armleo/armleo_gpio/xschem/gpio/netlists/libs.spice

.subckt sky130_fd_sc_hd__nand2_4 A B VGND VNB VPB VPWR Y
X0 a_27_47# A Y VNB sky130_fd_pr__nfet_01v8 w=650000u l=150000u
X1 a_27_47# A Y VNB sky130_fd_pr__nfet_01v8 w=650000u l=150000u
X2 Y A VPWR VPB sky130_fd_pr__pfet_01v8_hvt w=1e+06u l=150000u
X3 Y A VPWR VPB sky130_fd_pr__pfet_01v8_hvt w=1e+06u l=150000u
X4 VGND B a_27_47# VNB sky130_fd_pr__nfet_01v8 w=650000u l=150000u
X5 VPWR A Y VPB sky130_fd_pr__pfet_01v8_hvt w=1e+06u l=150000u
X6 Y A a_27_47# VNB sky130_fd_pr__nfet_01v8 w=650000u l=150000u
X7 a_27_47# B VGND VNB sky130_fd_pr__nfet_01v8 w=650000u l=150000u
X8 VGND B a_27_47# VNB sky130_fd_pr__nfet_01v8 w=650000u l=150000u
X9 VPWR B Y VPB sky130_fd_pr__pfet_01v8_hvt w=1e+06u l=150000u
X10 a_27_47# B VGND VNB sky130_fd_pr__nfet_01v8 w=650000u l=150000u
X11 VPWR A Y VPB sky130_fd_pr__pfet_01v8_hvt w=1e+06u l=150000u
X12 VPWR B Y VPB sky130_fd_pr__pfet_01v8_hvt w=1e+06u l=150000u
X13 Y B VPWR VPB sky130_fd_pr__pfet_01v8_hvt w=1e+06u l=150000u
X14 Y A a_27_47# VNB sky130_fd_pr__nfet_01v8 w=650000u l=150000u
X15 Y B VPWR VPB sky130_fd_pr__pfet_01v8_hvt w=1e+06u l=150000u
.ends


.subckt sky130_fd_sc_hd__nor2_4 A B VGND VNB VPB VPWR Y
X0 a_27_297# B Y VPB sky130_fd_pr__pfet_01v8_hvt w=1e+06u l=150000u
X1 Y A VGND VNB sky130_fd_pr__nfet_01v8 w=650000u l=150000u
X2 VPWR A a_27_297# VPB sky130_fd_pr__pfet_01v8_hvt w=1e+06u l=150000u
X3 VPWR A a_27_297# VPB sky130_fd_pr__pfet_01v8_hvt w=1e+06u l=150000u
X4 Y B a_27_297# VPB sky130_fd_pr__pfet_01v8_hvt w=1e+06u l=150000u
X5 VGND A Y VNB sky130_fd_pr__nfet_01v8 w=650000u l=150000u
X6 a_27_297# A VPWR VPB sky130_fd_pr__pfet_01v8_hvt w=1e+06u l=150000u
X7 a_27_297# A VPWR VPB sky130_fd_pr__pfet_01v8_hvt w=1e+06u l=150000u
X8 VGND A Y VNB sky130_fd_pr__nfet_01v8 w=650000u l=150000u
X9 Y B VGND VNB sky130_fd_pr__nfet_01v8 w=650000u l=150000u
X10 a_27_297# B Y VPB sky130_fd_pr__pfet_01v8_hvt w=1e+06u l=150000u
X11 Y A VGND VNB sky130_fd_pr__nfet_01v8 w=650000u l=150000u
X12 Y B VGND VNB sky130_fd_pr__nfet_01v8 w=650000u l=150000u
X13 Y B a_27_297# VPB sky130_fd_pr__pfet_01v8_hvt w=1e+06u l=150000u
X14 VGND B Y VNB sky130_fd_pr__nfet_01v8 w=650000u l=150000u
X15 VGND B Y VNB sky130_fd_pr__nfet_01v8 w=650000u l=150000u
.ends


.subckt sky130_fd_sc_hd__and2_4 A B VGND VNB VPB VPWR X
X0 a_27_47# B VPWR VPB sky130_fd_pr__pfet_01v8_hvt w=1e+06u l=150000u
X1 VPWR A a_27_47# VPB sky130_fd_pr__pfet_01v8_hvt w=1e+06u l=150000u
X2 a_110_47# B VGND VNB sky130_fd_pr__nfet_01v8 w=650000u l=150000u
X3 VGND a_27_47# X VNB sky130_fd_pr__nfet_01v8 w=650000u l=150000u
X4 a_27_47# A a_110_47# VNB sky130_fd_pr__nfet_01v8 w=650000u l=150000u
X5 X a_27_47# VGND VNB sky130_fd_pr__nfet_01v8 w=650000u l=150000u
X6 VPWR a_27_47# X VPB sky130_fd_pr__pfet_01v8_hvt w=1e+06u l=150000u
X7 VPWR a_27_47# X VPB sky130_fd_pr__pfet_01v8_hvt w=1e+06u l=150000u
X8 VGND a_27_47# X VNB sky130_fd_pr__nfet_01v8 w=650000u l=150000u
X9 X a_27_47# VPWR VPB sky130_fd_pr__pfet_01v8_hvt w=1e+06u l=150000u
X10 X a_27_47# VGND VNB sky130_fd_pr__nfet_01v8 w=650000u l=150000u
X11 X a_27_47# VPWR VPB sky130_fd_pr__pfet_01v8_hvt w=1e+06u l=150000u
.ends


.subckt sky130_fd_sc_hd__inv_4 A VGND VNB VPB VPWR Y
X0 Y A VGND VNB sky130_fd_pr__nfet_01v8 w=650000u l=150000u
X1 VGND A Y VNB sky130_fd_pr__nfet_01v8 w=650000u l=150000u
X2 VPWR A Y VPB sky130_fd_pr__pfet_01v8_hvt w=1e+06u l=150000u
X3 Y A VGND VNB sky130_fd_pr__nfet_01v8 w=650000u l=150000u
X4 VGND A Y VNB sky130_fd_pr__nfet_01v8 w=650000u l=150000u
X5 VPWR A Y VPB sky130_fd_pr__pfet_01v8_hvt w=1e+06u l=150000u
X6 Y A VPWR VPB sky130_fd_pr__pfet_01v8_hvt w=1e+06u l=150000u
X7 Y A VPWR VPB sky130_fd_pr__pfet_01v8_hvt w=1e+06u l=150000u
.ends



.subckt sky130_fd_sc_hvl__inv_4 A VGND VNB VPB VPWR Y
X0 Y A VPWR VPB sky130_fd_pr__pfet_g5v0d10v5 w=1.5e+06u l=500000u
X1 Y A VGND VNB sky130_fd_pr__nfet_g5v0d10v5 w=750000u l=500000u
X2 VGND A Y VNB sky130_fd_pr__nfet_g5v0d10v5 w=750000u l=500000u
X3 Y A VPWR VPB sky130_fd_pr__pfet_g5v0d10v5 w=1.5e+06u l=500000u
X4 VGND A Y VNB sky130_fd_pr__nfet_g5v0d10v5 w=750000u l=500000u
X5 VPWR A Y VPB sky130_fd_pr__pfet_g5v0d10v5 w=1.5e+06u l=500000u
X6 VPWR A Y VPB sky130_fd_pr__pfet_g5v0d10v5 w=1.5e+06u l=500000u
X7 Y A VGND VNB sky130_fd_pr__nfet_g5v0d10v5 w=750000u l=500000u
.ends



.subckt sky130_fd_sc_hvl__inv_16 A VGND VNB VPB VPWR Y
X0 Y A VGND VNB sky130_fd_pr__nfet_g5v0d10v5 w=750000u l=500000u
X1 Y A VGND VNB sky130_fd_pr__nfet_g5v0d10v5 w=750000u l=500000u
X2 Y A VGND VNB sky130_fd_pr__nfet_g5v0d10v5 w=750000u l=500000u
X3 Y A VGND VNB sky130_fd_pr__nfet_g5v0d10v5 w=750000u l=500000u
X4 Y A VPWR VPB sky130_fd_pr__pfet_g5v0d10v5 w=1.5e+06u l=500000u
X5 Y A VPWR VPB sky130_fd_pr__pfet_g5v0d10v5 w=1.5e+06u l=500000u
X6 VGND A Y VNB sky130_fd_pr__nfet_g5v0d10v5 w=750000u l=500000u
X7 Y A VPWR VPB sky130_fd_pr__pfet_g5v0d10v5 w=1.5e+06u l=500000u
X8 VGND A Y VNB sky130_fd_pr__nfet_g5v0d10v5 w=750000u l=500000u
X9 VGND A Y VNB sky130_fd_pr__nfet_g5v0d10v5 w=750000u l=500000u
X10 VPWR A Y VPB sky130_fd_pr__pfet_g5v0d10v5 w=1.5e+06u l=500000u
X11 VGND A Y VNB sky130_fd_pr__nfet_g5v0d10v5 w=750000u l=500000u
X12 VGND A Y VNB sky130_fd_pr__nfet_g5v0d10v5 w=750000u l=500000u
X13 VPWR A Y VPB sky130_fd_pr__pfet_g5v0d10v5 w=1.5e+06u l=500000u
X14 VGND A Y VNB sky130_fd_pr__nfet_g5v0d10v5 w=750000u l=500000u
X15 VGND A Y VNB sky130_fd_pr__nfet_g5v0d10v5 w=750000u l=500000u
X16 VPWR A Y VPB sky130_fd_pr__pfet_g5v0d10v5 w=1.5e+06u l=500000u
X17 VPWR A Y VPB sky130_fd_pr__pfet_g5v0d10v5 w=1.5e+06u l=500000u
X18 Y A VGND VNB sky130_fd_pr__nfet_g5v0d10v5 w=750000u l=500000u
X19 VPWR A Y VPB sky130_fd_pr__pfet_g5v0d10v5 w=1.5e+06u l=500000u
X20 VPWR A Y VPB sky130_fd_pr__pfet_g5v0d10v5 w=1.5e+06u l=500000u
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
X36 VPWR a_183_141# X VPB sky130_fd_pr__pfet_g5v0d10v5 w=1.5e+06u l=500000u
X37 VGND A a_183_141# VNB sky130_fd_pr__nfet_g5v0d10v5 w=750000u l=500000u
X38 VGND a_183_141# X VNB sky130_fd_pr__nfet_g5v0d10v5 w=750000u l=500000u
X39 X a_183_141# VPWR VPB sky130_fd_pr__pfet_g5v0d10v5 w=1.5e+06u l=500000u
X40 VGND A a_183_141# VNB sky130_fd_pr__nfet_g5v0d10v5 w=750000u l=500000u
X41 X a_183_141# VPWR VPB sky130_fd_pr__pfet_g5v0d10v5 w=1.5e+06u l=500000u
X42 VGND a_183_141# X VNB sky130_fd_pr__nfet_g5v0d10v5 w=750000u l=500000u
X43 X a_183_141# VPWR VPB sky130_fd_pr__pfet_g5v0d10v5 w=1.5e+06u l=500000u
.ends
