armleo/armleo_gpio/verilog/armleo_gpio.bb.v

(* blackbox *)
module armleo_gpio(
    `ifdef USE_POWER_PINS
        inout vddio,
        inout vssio,
        inout vdd,
        inout vss,
    `endif
    
    inout pad,
    
    input med_enable,
    input strong_enable,
    
    input out_l,
    input oe_l,
    output in
);



endmodule
