armleo/armleo_gpio/(commit log)

2022-01-22 armleo_gpio: V2: Cleaned up old files
    [armleo_gpio.sch, armleo_gpio_lv2hv.sch, armleo_gpio_lv2hv_tb.sch, armleo_gpio_lv2hv_tb_1v8.sch, armleo_gpio_tb.sch, armleo_gpio_worst_tb.sch]
2022-01-22 Makefile: Fixed reference to wrong .mk; Added verilog files
    [armleo_gpio.bb.v, armleo_gpio.tb.v, armleo_gpio.v, generate_makefile.py]
2022-02-11 updated fixed wrapper to add offsets to accomodate for power rails
2022-02-12 Fixed DEF pins being tied to zero/one/each other. Had to make a lot of workaround
    [carrack_wrapper.v]
2022-02-12 Updated readme to reflect on power rings connections
2022-02-26 WIP for successful LVS and power connected wrapper
2022-02-26 Added compress/decompress script; Pushing GDS with supposedly fixed oeb[2] vccd1 short
    [generate_makefile.py]
2022-03-06 Added ESD testbench
    [armleo_gpio_esd_tb.sch]
2022-03-18 Fixed DRCs due to pin size mismatch between top and def
